IvoZal/DP/Fabrication output/testbench-BOM-THT-mouser.xlsx

Quantity | GME | Designator | Mouser number | URL
2 | KLS MLW10G konektor | J3 | 538-70246-1004 | https://cz.mouser.com/ProductDetail/Molex/70246-1004?qs=R7%2FZKp6KZ2by8%252BhtUWbo%252BQ%3D%3D
0 | pruzinovy pogo kontakt samice | U6 | 575-4141000150000000 | https://cz.mouser.com/ProductDetail/Mill-Max/4141-0-00-15-00-00-03-0?qs=Znm5pLBrcAKrk2sGDtRJwQ%3D%3D | https://www.digikey.com/en/products/detail/mill-max-manufacturing-corp/4141-0-00-15-00-00-03-0/16341759
0 | CONNFLY S2G06C, kolikova lista 2x3 pin | J2 | 649-1012938190602BLF | https://cz.mouser.com/ProductDetail/Amphenol-FCI/10129381-906002BLF?qs=DXv0QSHKF4zSKXKyBbBVMw%3D%3D
3 | dutinkova lista 8 pin | U7, U8 | 992-8FX1L-254MM | https://cz.mouser.com/ProductDetail/Gravitech/8Fx1L-254mm?qs=fkzBJ5HM%252BdAyuablm941Ag%3D%3D
0 | CONNFLY S1G02C kolíková lišta 1x2 pin | LS1 | 200-TSW10207TS | https://cz.mouser.com/ProductDetail/Samtec/TSW-102-07-T-S?qs=hzq9O0YpnZuE%252BS9CaLPVlQ%3D%3D
1 | BL104G-V5,7 dutinková lišta 1x4pin | U2 | 710-61300411821 | https://cz.mouser.com/ProductDetail/Wurth-Elektronik/61300411821?qs=iLbezkQI%252BsgYrk24CGHgKQ%3D%3D
3 | dutinková lišta 1x6pin 2.54mm roztec | U4, U8 | 710-61300611821 | https://cz.mouser.com/ProductDetail/Wurth-Elektronik/61300611821?qs=iLbezkQI%252BsgS21jF2eozhA%3D%3D
1 | KLS BL105G-V8.5 dutinková lišta 1x5 pin | U3 | 710-61300511821 | https://cz.mouser.com/ProductDetail/Wurth-Elektronik/61300511821?qs=iLbezkQI%252BsjtLywwvTh3KA%3D%3D
0 | CONNFLY S1G04C kolíková lišta 1x4 pin | U6 | 523-G800W304018EU | https://cz.mouser.com/ProductDetail/Amphenol-Commercial-Products/G800W304018EU?qs=f9yNj16SXrKi9QS16pMdvA%3D%3D
0 | CONNFLY S1G06C kolíková lišta 1x6 | U5 | 649-1012937890601BLF | https://cz.mouser.com/ProductDetail/Amphenol-FCI/10129378-906001BLF?qs=0lQeLiL1qybdgsDy2F9d0g%3D%3D
0 | KLS S1G08C kolíková lišta 1x8 | U5 | 649-1012937890801BLF | https://cz.mouser.com/ProductDetail/Amphenol-FCI/10129378-908001BLF?qs=0lQeLiL1qybDtVkZc9V5DA%3D%3D
0 | KLS S1G10C kolíková lišta 1x10 | U5 | 649-1012937891001BLF | https://cz.mouser.com/ProductDetail/Amphenol-FCI/10129378-910001BLF?qs=0lQeLiL1qyaKTim8PTf2WA%3D%3D
0 | distancni slopek plastovy 10mm
1 | 5 zilovy kabel
 | 1x kabel 5 zilovy samec/samice
 | 1x kabel 4 zilovy samice/samice
pogo piny
tme | https://www.tme.eu/cz/details/pogo-pin2mmx11.3mm/konektory-ostatni/
