IvoZal/DP/Fabrication output/testbench-BOM.xlsx

Comment | Designator | Footprint | LCSC Part Number
100n | C4,C7,C9,C11,C8,C6,C5 | 0805 | C28233
1uF | C10 | 0805 | C28323
1k | R23,R17,R21,R28,R20,R27,R22,R24,R18,R25,R19,R26 | 0805 | C17513
22p | C3,C2 | 0805 | C1804
5.1k | R2,R1 | 0805 | C27834
10k | R10,R12,R11,R13,R9 | 0805 | C17414
330R | R33,R38,R7,R45,R35,R42,R36,R47,R41,R56,R53,R43,R54,R5,R16,R44,R6,R48,R29,R34,R3,R46,R32,R37,R31,R49,R52,R39,R55,R40,R51,R50,R30 | 0805 | C17630
LED green | D1 | 0805 | C2297
USB-TYPE-C | J1 |  | C5307759
USBLC6-2SC6 | U9 | SOT-23-6 | C85364
ATmega2561-16A | U1 | TQFP-64 | C113558
200R | R14 | 0805 | C17540
4.7uF | C1 | 0805 | C1779
CH340C | U10 | SOIC-16 | C84681
100R@100MHz | FB1 | 0805 | C1015
4.7k | R4 | 0805 | C17673
16MHz | Y1 | SMD3225-4P | C13738
470R | R15 | 0805 | C17710
NO Tactile SPST | SW1 | SMD | C318884
500mA | F1 | 0805 | C2833485
1M | R8 | 0805 | C17514
