IvoZal/DP/test-report.csv

Kit number | ATmega328P Xplained Mini | Rele modul | RTC a EEPROM modul | Rotacni enkoder | Maticova klavesnice | Tlacitka na LCD modulu | Modul LCD displeje | Reproduktor | Modul s termistorem
009 | FAIL | PASS | PASS | PASS | PASS | PASS | PASS | PASS | PASS
017 | FAIL | PASS | PASS | PASS | PASS | PASS | PASS | PASS | PASS
013 | PASS | PASS | PASS | PASS | PASS | PASS | PASS | PASS | PASS
