IvoZal/DP/testbench-PCB/testbench.kicad_pcb

## KiCad design testbench-PCB/testbench.kicad_pcb (2023-12-13)

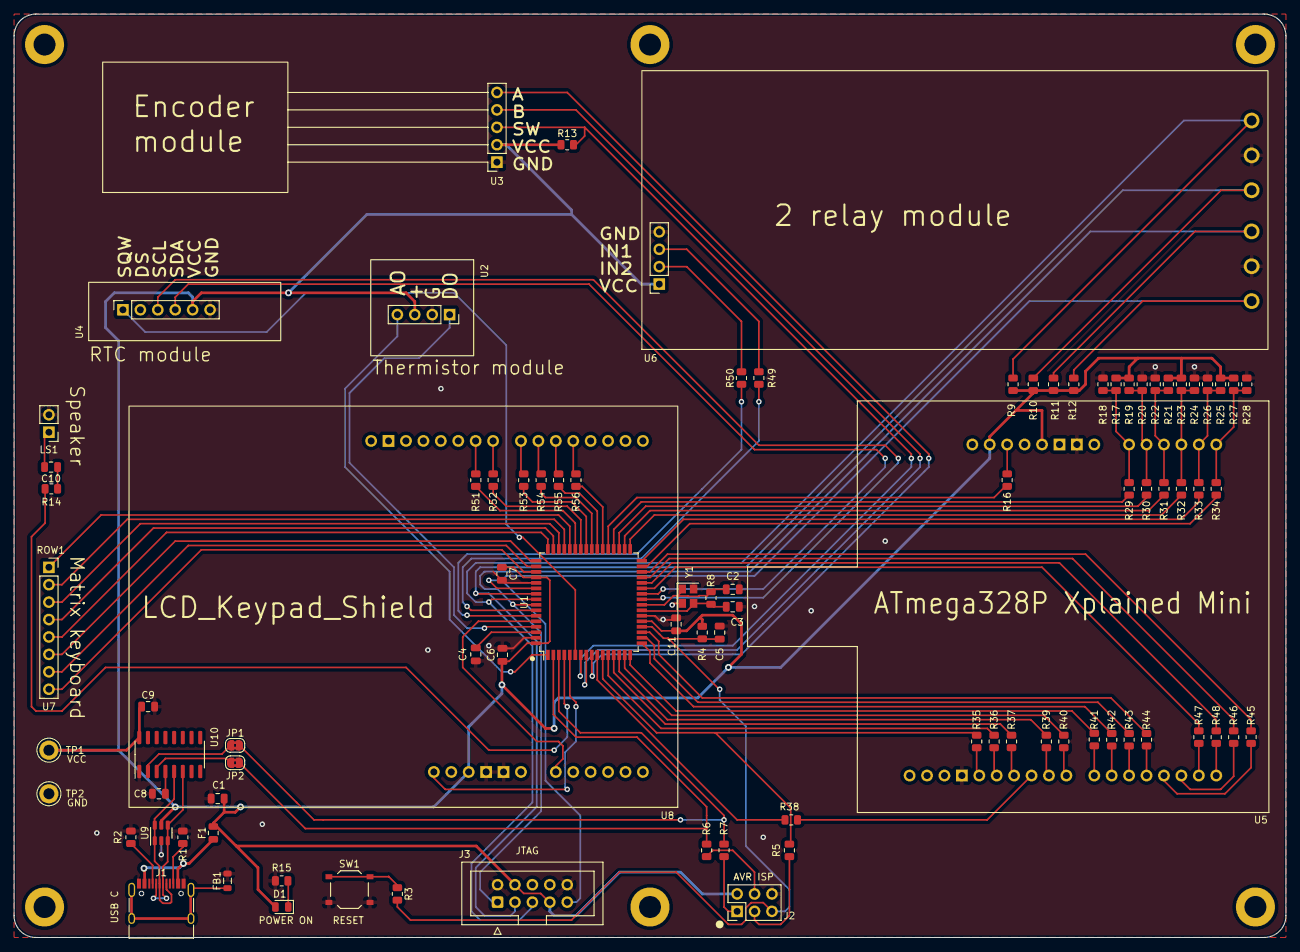
[picture p1: board testbench.kicad_pcb from above]

Board: 2 copper layers, 185.4 x 134.6 mm, 90 parts (0 on the bottom side), 105 nets.

Parts:
C1: 4.7uF; C_0805_2012Metric
C2, C3: 22p; C_0805_2012Metric
C4, C5, C6, C7, C8, C9, C11: 100n; C_0805_2012Metric
C10: 1uF; C_0805_2012Metric
D1: LED; LED_0805_2012Metric
F1: 500mA; Fuse_0805_2012Metric
FB1: 100R@100MHz; L_0805_2012Metric
J1: USB_C_Receptacle_USB2.0; USB_C_Receptacle_HRO_TYPE-C-31-M-12
J2: AVR-ISP; PinHeader_2x03_P2.54mm_Vertical
J3: AVR-JTAG; IDC-Header_2x05_P2.54mm_Vertical
JP1, JP2: SolderJumper_2_Bridged; SolderJumper-2_P1.3mm_Bridged2Bar_RoundedPad1.0x1.5mm
LS1: Speaker; PinHeader_1x02_P2.54mm_Vertical
R1, R2: 5.1k; R_0805_2012Metric
R3, R5, R6, R7, R16, R29, R30, R31, R32, R33, R34, R35, R36, R37, R38, R39, R40, R41, R42, R43, R44, R45, R46, R47, R48, R49, R50, R51, R52, R53, R54, R55, R56: 330R; R_0805_2012Metric
R4: 4.7k; R_0805_2012Metric
R8: 1M; R_0805_2012Metric
R9, R10, R11, R12, R13: 10k; R_0805_2012Metric
R14: 200R; R_0805_2012Metric
R15: 470R; R_0805_2012Metric
R17, R18, R19, R20, R21, R22, R23, R24, R25, R26, R27, R28: 1k; R_0805_2012Metric
SW1: SW_Push; SW_Push_1P1T_XKB_TS-1187A
TP1, TP2: TestPoint; TestPoint_Keystone_5005-5009_Compact
U1: ATmega2561-16A; TQFP-64_14x14mm_P0.8mm
U2: Thermistor_module
U3: Rotary_encoder_switch_module; Rotary_encoder_module
U4: RTC_EEPROM_module; RTC_module
U5: ATmega328P_Xplained_mini
U6: Relay_module
U7: Matrix_keyboard; PinSocket_1x08_P2.54mm_Vertical
U8: LCD_display; LCD_1602A_module
U9: USBLC6-2SC6; SOT-23-6
U10: CH340C; SOIC-16_3.9x9.9mm_P1.27mm
Y1: X322516MLB4SI; Oscillator_SMD_Abracon_ASE-4Pin_3.2x2.5mm

Connections:
+5V: C1.1, C6.1, C7.1, C9.1, C11.1, D1.2 (A), F1.2, J2.2 (VCC), J3.4 (VREF), J3.7 (VCC), R4.1, R9.1, R10.1, R11.1, R12.1, R13.1, R17.1, R19.1, R21.1, R23.1, R25.1, R27.1, TP1.1, U1.21 (VCC), U1.52 (VCC), U1.64 (AVCC), U2.3 (+), U3.4 (+), U4.5 (VCC), U5.20 (VCC), U5.23 (5V), U6.4 (Vcc), U8.19 (5V), U9.5 (VBUS), U10.16 (VCC)
/ATmega328P module/D0: R16.2, U5.21 (~RESET/PC6)
/ATmega328P module/D1: R17.2, R18.1, R29.2, U5.27 (PC0)
/ATmega328P module/D2: R19.2, R20.1, R30.2, U5.28 (PC1)
/ATmega328P module/D3: R21.2, R22.1, R31.2, U5.29 (PC2)
/ATmega328P module/D4: R23.2, R24.1, R32.2, U5.30 (PC3)
/ATmega328P module/D5: R25.2, R26.1, R33.2, U5.31 (PC4)
/ATmega328P module/D6: R27.2, R28.1, R34.2, U5.32 (PC5)
/ATmega328P module/D7: R35.1, U5.14 (PB5)
/ATmega328P module/D8: R36.1, U5.13 (PB4)
/ATmega328P module/D9: R37.1, U5.12 (PB3)
/ATmega328P module/D10: R38.1, U5.11 (PB2)
/ATmega328P module/D11: R39.1, U5.10 (PB1)
/ATmega328P module/D12: R40.1, U5.9 (PB0)
/ATmega328P module/D13: R41.1, U5.8 (PD7)
/ATmega328P module/D14: R42.1, U5.7 (PD6)
/ATmega328P module/D15: R43.1, U5.6 (PD5)
/ATmega328P module/D16: R44.1, U5.5 (PD4)
/ATmega328P module/D17: R45.1, U5.4 (PD3)
/ATmega328P module/D18: R46.1, U5.3 (PD2)
/ATmega328P module/D19: R47.1, U5.2 (PD1)
/ATmega328P module/D20: R48.1, U5.1 (PD0)
/ATmega328P module/DUT_D0: R16.1, U1.37 (PC2)
/ATmega328P module/DUT_D1: R29.1, U1.36 (PC1)
/ATmega328P module/DUT_D2: R30.1, U1.35 (PC0)
/ATmega328P module/DUT_D3: R31.1, U1.34 (PG1)
/ATmega328P module/DUT_D4: R32.1, U1.33 (PG0)
/ATmega328P module/DUT_D5: R33.1, U1.32 (PD7)
/ATmega328P module/DUT_D6: R34.1, U1.31 (PD6)
/ATmega328P module/DUT_D7: R48.2, U1.28 (PD3)
/ATmega328P module/DUT_D8: R47.2, U1.27 (PD2)
/ATmega328P module/DUT_D9: R46.2, U1.29 (PD4)
/ATmega328P module/DUT_D10: R45.2, U1.30 (PD5)
/ATmega328P module/DUT_D11: R44.2, U1.19 (PG4)
/ATmega328P module/DUT_D12: R43.2, U1.18 (PG3)
/ATmega328P module/DUT_D13: R42.2, U1.17 (PB7)
/ATmega328P module/DUT_D14: R41.2, U1.16 (PB6)
/ATmega328P module/DUT_D15: R40.2, U1.15 (PB5)
/ATmega328P module/DUT_D16: R39.2, U1.14 (PB4)
/ATmega328P module/DUT_D17: R38.2, U1.10 (PB0)
/ATmega328P module/DUT_D18: R37.2, U1.13 (PB3)
/ATmega328P module/DUT_D19: R36.2, U1.12 (PB2)
/ATmega328P module/DUT_D20: R5.1, R35.2, U1.11 (PB1)
/Kit modules/ENC.A: U1.9 (PE7), U3.1 (CLK)
/Kit modules/ENC.B: U1.8 (PE6), U3.2 (DT)
/Kit modules/ENC.SW: R13.2, U1.7 (PE5), U3.3 (SW)
/Kit modules/I2C_SCL: U1.25 (PD0), U4.3 (SCL)
/Kit modules/I2C_SDA: U1.26 (PD1), U4.4 (SDA)
/Kit modules/K1-IN: R49.1, U1.58 (PF3)
/Kit modules/K1-NC: J3.5 (TMS), R9.2, U1.56 (PF5), U6.5 (K1-NC)
/Kit modules/K1-NO: J3.3 (TDO), R10.2, U1.55 (PF6), U6.7 (K1-NO)
/Kit modules/K2-IN: R50.1, U1.59 (PF2)
/Kit modules/K2-NC: J3.1 (TCK), R11.2, U1.57 (PF4), U6.8 (K2-NC)
/Kit modules/K2-NO: J3.9 (TDI), R12.2, U1.54 (PF7), U6.10 (K2-NO)
/Kit modules/KEY_D0: U1.44 (PA7), U7.1 (ROW1)
/Kit modules/KEY_D1: U1.45 (PA6), U7.2 (ROW2)
/Kit modules/KEY_D2: U1.46 (PA5), U7.3 (ROW3)
/Kit modules/KEY_D3: U1.47 (PA4), U7.4 (ROW4)
/Kit modules/KEY_D4: U1.48 (PA3), U7.5 (COL1)
/Kit modules/KEY_D5: U1.49 (PA2), U7.6 (COL2)
/Kit modules/KEY_D6: U1.50 (PA1), U7.7 (COL3)
/Kit modules/KEY_D7: U1.51 (PA0), U7.8 (COL4)
/Kit modules/LCD_AO: U1.60 (PF1), U8.23 (A0)
/Kit modules/LCD_D0: R56.2, U1.38 (PC3)
/Kit modules/LCD_D1: R55.2, U1.39 (PC4)
/Kit modules/LCD_D2: R54.2, U1.40 (PC5)
/Kit modules/LCD_D3: R53.2, U1.41 (PC6)
/Kit modules/LCD_D4: R52.2, U1.42 (PC7)
/Kit modules/LCD_D5: R51.2, U1.43 (PG2)
/Kit modules/LCD_D6: U1.5 (PE3), U8.17 (RST)
/Kit modules/RTC_SQW: U1.6 (PE4), U4.1 (SQ)
/Kit modules/Speaker_IN: R14.1, U1.4 (PE2)
/Kit modules/Thermistor_AO: U1.61 (PF0), U2.1 (AO)
/Kit modules/Thermistor_DO: U1.1 (PG5), U2.4 (DO)
/MCU/RST: C5.1, J2.5 (~RST), R3.2, R4.2, U1.20 (~RESET)
/MCU/UART0_RXD: JP2.2 (B), R6.1, U1.2 (PE0)
/MCU/UART0_TXD: JP1.2 (B), R7.1, U1.3 (PE1)
/USB Interface/VBUS: F1.1, J1.A4 (VBUS), J1.A9 (VBUS), J1.B4 (VBUS), J1.B9 (VBUS)
GND: C1.2, C2.1, C3.1, C4.2, C5.2, C6.2, C7.2, C8.2, C9.2, C11.2, FB1.2, J1.A1 (GND), J1.A12 (GND), J1.B1 (GND), J1.B12 (GND), J2.6 (GND), J3.2 (GND), J3.10 (GND), LS1.2, R1.2, R2.2, R15.2, R18.2, R20.2, R22.2, R24.2, R26.2, R28.2, SW1.2, TP2.1, U1.22 (GND), U1.53 (GND), U1.63 (GND), U2.2 (GND), U3.5 (GND), U4.6 (GND), U5.15 (GND), U5.25 (GND), U6.1 (GND), U6.6 (K1-COM), U6.9 (K2-COM), U8.20 (GND), U8.21 (GND), U9.2 (GND), U10.1 (GND), Y1.2, Y1.4
unnamed: C10.1, R14.2
unnamed: C10.2, LS1.1
unnamed: D1.1 (K), R15.1
unnamed: J1.A5 (CC1), R2.1
unnamed: J1.B5 (CC2), R1.1
unnamed: FB1.1, J1.S1 (SHIELD)
unnamed: J2.1 (MISO), R7.2
unnamed: J2.4 (MOSI), R6.2
unnamed: J2.3 (SCK), R5.2
unnamed: JP1.1 (A), U10.2 (TXD)
unnamed: JP2.1 (A), U10.3 (RXD)
unnamed: R3.1, SW1.1
unnamed: C4.1, U1.62 (AREF)
unnamed: C2.2, R8.1, U1.24 (XTAL1), Y1.1
unnamed: C3.2, R8.2, U1.23 (XTAL2), Y1.3
unnamed: R49.2, U6.2 (IN1)
unnamed: R50.2, U6.3 (IN2)
unnamed: R56.1, U8.5 (D4)
unnamed: R55.1, U8.6 (D5)
unnamed: R54.1, U8.7 (D6)
unnamed: R53.1, U8.8 (D7)
unnamed: R51.1, U8.10 (E)
unnamed: R52.1, U8.9 (RS)
unnamed: J1.A6 (D+), J1.B6 (D+), U9.1 (I/O1), U9.6 (I/O1), U10.5 (UD+)
unnamed: J1.A7 (D-), J1.B7 (D-), U9.3 (I/O2), U9.4 (I/O2), U10.6 (UD-)
unnamed: C8.1, U10.4 (V3)
