IvoZal/DP/test_app/testappcontrol.py

import tkinter as tk
import threading
import time
import subprocess
import csv
import sys

class Device:
    def __init__(self, name):
        self.name = name
        self.run = True
        self.tk_var = tk.BooleanVar(value=self.run)
        self.result = "INIT"
        self.err_message = ""
        self.label = {"status" : None, "error" : None}
        self.data = []
        self.serial_read_flag = False

class TestAppController:
    def __init__(self, model, view):
        self.model = model
        self.view = view
        self.selected_port = tk.StringVar(value="")
        self.log_flag = tk.IntVar()
        self.log_filename = ""
        self.test_devices = [Device("ATmega328P Xplained Mini"),
                             Device("Rele modul"),
                             Device("RTC a EEPROM modul"),
                             Device("Rotacni enkoder"),
                             Device("Maticova klavesnice"),
                             Device("Tlacitka na LCD modulu"),
                             Device("Modul LCD displeje"),
                             Device("Reproduktor"),
                             Device("Modul s termistorem"),]
        
    def start_adc_read(self, device):
        while device.serial_read_flag:
            try:
                data = self.model.read_data(None)
                raw_data = int(data.replace("ADC: ",""))
                device.data.append(5*raw_data/1023)
                if len(device.data) > 20:
                    device.data.pop(0)
            except ValueError:
                pass
            
    def interact_test(self, device):
        def check_serial_data():
            nonlocal device
            while device.serial_read_flag:
                try:
                    test_result = self.model.eval_test(0)
                    if test_result[0]:
                        device.result = "PASS"
                        device.err_message = ""
                        self.view.window.save_result(True)
                    elif test_result[1] != "":
                        device.result = "FAIL"
                        device.err_message = test_result[1]
                        self.view.window.missing_input(device.err_message)
                except Exception as e:
                    print(f"Error in check_serial_data: {e}")
                time.sleep(0.1)

        # Start the serial reading loop in a separate thread
        serial_reader_thread = threading.Thread(target=check_serial_data)
        serial_reader_thread.start()

    def program_m328p(self):
        self.view.update_prog_status("Nahrávání...")
        time.sleep(0.1)
        if getattr(sys, 'frozen', False):
            # Running in PyInstaller
            avrdude_path = sys._MEIPASS + "/avrdude"
            binary_path = sys._MEIPASS + "/ATmega328P_test_prog.hex"
        else:
            # Running in a Python environment
            avrdude_path = "avrdude/avrdude"
            binary_path = "m328p_binary/ATmega328P_test_prog.hex"
        
        avrdude_cmd = avrdude_path + " -p m328p -c xplainedmini_dw -U flash:w:" + binary_path
        print(avrdude_cmd)
        try:
            subprocess.check_output(avrdude_cmd)
            self.view.update_prog_status("Program byl úspěšně nahrán.")
        except subprocess.CalledProcessError as e:
            self.view.update_prog_status("Nahrávání programu selhalo.")
        
    def start_clicked(self):
        com_port = self.selected_port.get()
        self.view.err_label.config(text="")
        try:
            self.model.init_serial(com_port, 38400)
            self.view.comm_label.config(text="Vybrán port " + com_port)
        except Exception as e:
            if(com_port == ""):
                self.view.comm_label.config(text="COM port nebyl vybrán!")
            else:
                self.view.comm_label.config(text="Vybraný COM port není přístupný: " + com_port)
            pass
        else:
            self.model.write("TEST INIT")
            for device in self.test_devices:
                match device.name:
                    case "ATmega328P Xplained Mini":
                        device.err_message = ""
                        if(device.run):
                            test_result = self.model.self_test("TEST ATMEGA")
                            if(test_result[0]):
                                device.result = "PASS"
                            else:
                                device.result = "FAIL"
                                device.err_message = test_result[1]
                        else:
                            device.result = "SKIPPED"

                    case "Rele modul":
                        device.err_message = ""
                        if(device.run):
                            test_result = self.model.self_test("TEST RELAY")
                            if(test_result[0]):
                                device.result = "PASS"
                            else:
                                device.result = "FAIL"
                                device.err_message = test_result[1]
                        else:
                            device.result = "SKIPPED"

                    case "RTC a EEPROM modul":
                        device.err_message = ""
                        if(device.run):
                            test_result = self.model.self_test("TEST RTC", timeout=1)
                            if(test_result[0]):
                                device.result = "PASS"
                            else:
                                device.result = "FAIL"
                                device.err_message = test_result[1]
                        else:
                            device.result = "SKIPPED"

                    case "Rotacni enkoder":
                        device.err_message = ""
                        if(device.run):
                            self.model.write("TEST ENCODER")

                            test_thread = threading.Thread(target=self.interact_test, args=(device,))
                            device.serial_read_flag = True
                            test_thread.start()

                            self.view.open_window(device)   
                            device.serial_read_flag = False
                            self.model.write("STOP")      
                        else:
                            device.result = "SKIPPED"

                    case "Maticova klavesnice":
                        device.err_message = ""
                        if(device.run):
                            device.result = "INIT"
                            self.model.write("TEST KEYBRD")

                            test_th = threading.Thread(target=self.interact_test, args=(device,))
                            device.serial_read_flag = True
                            test_th.start()

                            self.view.open_window(device)        
                            device.serial_read_flag = False  
                            self.model.write("STOP")
                        else:
                            device.result = "SKIPPED"

                    case "Tlacitka na LCD modulu":
                        device.err_message = ""
                        if(device.run):
                            device.result = "INIT"
                            self.model.write("TEST BTN")

                            test_th = threading.Thread(target=self.interact_test, args=(device,))
                            device.serial_read_flag = True
                            test_th.start()

                            self.view.open_window(device)        
                            device.serial_read_flag = False  
                            self.model.write("STOP")
                        else:
                            device.result = "SKIPPED"

                    case "Modul LCD displeje":
                        device.err_message = ""
                        if(device.run):
                            self.model.write("TEST LCD")
                            self.view.open_window(device)
                            self.model.write("STOP")
                        else:
                            device.result = "SKIPPED"

                    case "Reproduktor":
                        if(device.run):
                            self.model.write("TEST SPEAKER")
                            self.view.open_window(device)
                            self.model.write("STOP")
                        else:
                            device.result = "SKIPPED"

                    case "Modul s termistorem":
                        if(device.run):
                            self.model.write("TEST THERM")

                            device.serial_read_flag = True
                            serial_thread = threading.Thread(target=self.start_adc_read, args=(device,))
                            serial_thread.start()

                            self.view.open_window(device)   
                            device.serial_read_flag = False
                            self.model.write("STOP")                 
                        else:
                            device.result = "SKIPPED"

                    case others:
                        pass
                    
                self.view.update_status_label(device)
                self.model.ser.reset_input_buffer()
                time.sleep(0.01)
            self.model.close_serial()
            self.view.update_prog_status("")

            if(self.log_flag.get() == 1):
                if(self.log_filename != ""):
                    kit_name = self.view.get_kit_name()
                    if kit_name is not None:
                        try:
                            csvfile = open(self.log_filename, 'a', newline='')
                            writer = csv.writer(csvfile)
                            report_list = [kit_name]
                            for device in self.test_devices:
                                report_list.append(device.result)
                            writer.writerow(report_list)
                            csvfile.close()
                        except Exception as e:
                            self.view.err_label.config(text="Chyba při zápisu do souboru!")
                    else:
                        self.view.err_label.config(text="Nebylo zadáno číslo kitu, report nebyl uložen!")
                else:
                    self.view.err_label.config(text="Logovací soubor nebyl vytvořen!")
