IvoZal/DP/ATmega2561_test_program/atmega2561_example/src/driver_init.c

/**
 * \file
 *
 * \brief Driver initialization.
 *
 (c) 2020 Microchip Technology Inc. and its subsidiaries.

    Subject to your compliance with these terms,you may use this software and
    any derivatives exclusively with Microchip products.It is your responsibility
    to comply with third party license terms applicable to your use of third party
    software (including open source software) that may accompany Microchip software.

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
    IN NO EVENT WILL MICROCHIP BE LIABLE FOR ANY INDIRECT, SPECIAL, PUNITIVE,
    INCIDENTAL OR CONSEQUENTIAL LOSS, DAMAGE, COST OR EXPENSE OF ANY KIND
    WHATSOEVER RELATED TO THE SOFTWARE, HOWEVER CAUSED, EVEN IF MICROCHIP HAS
    BEEN ADVISED OF THE POSSIBILITY OR THE DAMAGES ARE FORESEEABLE. TO THE
    FULLEST EXTENT ALLOWED BY LAW, MICROCHIP'S TOTAL LIABILITY ON ALL CLAIMS IN
    ANY WAY RELATED TO THIS SOFTWARE WILL NOT EXCEED THE AMOUNT OF FEES, IF ANY,
    THAT YOU HAVE PAID DIRECTLY TO MICROCHIP FOR THIS SOFTWARE.
 *
 */

/*
 * Code generated by START.
 *
 * This file will be overwritten when reconfiguring your START project.
 * Please copy examples or other code you want to keep to a separate file
 * to avoid losing it when reconfiguring.
 */

#include "driver_init.h"
#include <system.h>

/* Configure pins and initialize registers */
void ADC_0_initialization(void)
{

	ADC_0_init();
}

/* configure the pins and initialize the registers */
void SPI_0_initialization(void)
{

	// Set pin direction to input
	PB3_set_dir(PORT_DIR_IN);

	PB3_set_pull_mode(
	    // <y> Pull configuration
	    // <id> pad_pull_config
	    // <PORT_PULL_OFF"> Off
	    // <PORT_PULL_UP"> Pull-up
	    PORT_PULL_OFF);

	// Set pin direction to output
	PB2_set_dir(PORT_DIR_OUT);

	PB2_set_level(
	    // <y> Initial level
	    // <id> pad_initial_level
	    // <false"> Low
	    // <true"> High
	    false);

	// Set pin direction to output
	PB1_set_dir(PORT_DIR_OUT);

	PB1_set_level(
	    // <y> Initial level
	    // <id> pad_initial_level
	    // <false"> Low
	    // <true"> High
	    false);

	SPI_init();
	SPI_disable();
}

/* configure pins and initialize registers */
void USART_0_initialization(void)
{

	// Set pin direction to input
	PE0_set_dir(PORT_DIR_IN);

	PE0_set_pull_mode(
	    // <y> Pull configuration
	    // <id> pad_pull_config
	    // <PORT_PULL_OFF"> Off
	    // <PORT_PULL_UP"> Pull-up
	    PORT_PULL_OFF);

	// Set pin direction to output
	PE1_set_dir(PORT_DIR_OUT);

	PE1_set_level(
	    // <y> Initial level
	    // <id> pad_initial_level
	    // <false"> Low
	    // <true"> High
	    false);

	USART0_init(38400);
}

/* configure pins and initialize registers */
void USART_1_initialization(void)
{

	// Set pin direction to input
	PD2_set_dir(PORT_DIR_IN);

	PD2_set_pull_mode(
	    // <y> Pull configuration
	    // <id> pad_pull_config
	    // <PORT_PULL_OFF"> Off
	    // <PORT_PULL_UP"> Pull-up
	    PORT_PULL_OFF);

	// Set pin direction to output
	PD3_set_dir(PORT_DIR_OUT);

	PD3_set_level(
	    // <y> Initial level
	    // <id> pad_initial_level
	    // <false"> Low
	    // <true"> High
	    false);

	USART1_init(38400);
}

/**
 * \brief System initialization
 */
void system_init()
{
	mcu_init();

	sysctrl_init();

	ADC_0_initialization();

	SPI_0_initialization();

	USART_0_initialization();

	USART_1_initialization();
}
