IvoZal/DP/(commit log)

2023-10-29 Added project, schematics.
    [testbench-backups.kicad_pcb, testbench-backups.kicad_sch]
2023-10-30 Added the rest of kit modules.
    [testbench-backups.kicad_sch]
2023-10-30 Added minimal MCU circuit, power supply from USB.
    [kit_modules.kicad_sch, power_supply.kicad_sch, testbench-backups.kicad_sch, untitled.kicad_sch]
2023-10-30 Changed USB interface name, MCU moved to separate sheet.
    [kit_modules.kicad_sch, mcu.kicad_sch, testbench-backups.kicad_sch, usb_interface.kicad_sch]
2023-10-30 Renamed whole project.
    [testbench.kicad_pcb, testbench.kicad_sch]
2023-11-05 Added USB interface.
    [kit_modules.kicad_sch, mcu.kicad_sch, testbench.kicad_sch, usb_interface.kicad_sch]
2023-11-06 Added connection between some modules.
    [kit_modules.kicad_sch, mcu.kicad_sch, testbench.kicad_sch, untitled.kicad_sch, usb_interface.kicad_sch]
2023-11-07 Finished connection between modules and MCU.
    [kit_modules.kicad_sch, mcu.kicad_sch, testbench.kicad_sch, untitled.kicad_sch, usb_interface.kicad_sch]
2023-11-08 Added footprints to few parts.
    [kit_modules.kicad_sch, mcu.kicad_sch]
2023-11-09 Changed naming convention.
    [kit_modules.kicad_sch, mcu.kicad_sch, testbench.kicad_sch, untitled.kicad_sch, usb_interface.kicad_sch]
2023-11-11 Connecter speaker, added JTAG.
    [kit_modules.kicad_sch, mcu.kicad_sch, testbench.kicad_sch, usb_interface.kicad_sch]
2023-11-11 Created PCB, changed footprints for symbols.
    [kit_modules.kicad_sch, mcu.kicad_sch, testbench.kicad_pcb, usb_interface.kicad_sch]
2023-11-12 Updated footprints, PCB.
    [kit_modules.kicad_sch, testbench.kicad_pcb, usb_interface.kicad_sch]
2023-11-12 Added submodule with KiCad lib.
2023-11-12 Routed osc., USB interface.
    [kit_modules.kicad_sch, mcu.kicad_sch, testbench.kicad_pcb, usb_interface.kicad_sch]
2023-11-14 Rearanged PCB, updated footprints.
    [mcu.kicad_sch, testbench.kicad_pcb, testbench.kicad_sch, untitled.kicad_sch]
2023-11-14 Renamed atmega328p sheet.
    [atmega328p.kicad_sch, testbench.kicad_sch]
2023-11-14 Fixed footprints in schematics.
    [atmega328p.kicad_sch, kit_modules.kicad_sch, testbench.kicad_pcb]
2023-11-20 Routing the PCB.
    [atmega328p.kicad_sch, kit_modules.kicad_sch, mcu.kicad_sch, testbench.kicad_pcb, testbench.kicad_sch, usb_interface.kicad_sch]
2023-11-21 Finished PCB routing, added ground plane.
    [kit_modules.kicad_sch, mcu.kicad_sch, testbench.kicad_pcb, usb_interface.kicad_sch]
2023-11-21 Resolved DRC warnings and errors.
    [testbench.kicad_pcb]
2023-11-21 Changes regarding part selection.
    [testbench-BOM.xlsx, testbench.kicad_pcb, usb_interface.kicad_sch]
2023-11-21 Changed encoder module pinout, added labels.
    [mcu.kicad_sch, testbench-BOM.csv, testbench.kicad_pcb]
2023-11-27 Added protective resistors.
    [atmega328p.kicad_sch, kit_modules.kicad_sch, testbench.kicad_pcb]
2023-11-27 Added logo and label. Rearanged labels.
    [testbench.kicad_pcb]
2023-11-27 DRC resolved.
    [testbench-BOM.csv, testbench-BOM.xlsx, testbench.kicad_pcb]
2023-11-28 Labels moved in schematics.
    [atmega328p.kicad_sch, kit_modules.kicad_sch, mcu.kicad_sch]
2023-12-05 Edited relay module output pins.
    [testbench.kicad_pcb]
2023-12-05 Exported fabrication outputs.
    [testbench-BOM.xlsx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]
2023-12-05 BOM for THT parts.
    [testbench-BOM-THT.xlsx]
2023-12-05 Created projects for both MCUs. Added gitignores.
    [testbench-BOM-THT-mouser.xlsx]
2024-01-04 Fixed adc reading.
2024-01-04 Added missing function definition.
    [uart.h]
2024-01-05 Error returned if invalid cmd passed.
    [main.c]
2024-01-05 Added uart lib.
2024-01-14 Added start and exit button.
2024-01-30 Fixed COM port menu, added label for communication.
    [testappview.py]
2024-01-31 Added draft for display and thermistor test view.
2024-02-01 Added thermistor test graph, TBD: graph update from serial.
2024-02-03 Added encoder test case.
2024-02-03 Edited error label printing.
    [testappview.py]
2024-02-03 Added matrix keyboard test case.
2024-02-03 Run all tests in default, concendate error messages.
    [testappcontrol.py]
2024-02-05 Fixed thread while loop condition.
    [testappcontrol.py, testappview.py]
2024-02-05 Added frames around group of features, added error message print.
    [testappcontrol.py, testappview.py]
2024-02-06 Added GME part names for THT BOM.
    [testbench-BOM-THT-mouser.xlsx]
2024-02-06 Added library for higher level UART handling.
2024-02-08 Added function prototypes with functionality description.
2024-02-08 Added reproductor test case.
2024-02-08 Added function for common init, added thermistor test case.
2024-02-08 Added missing test for display buttons.
    [testappcontrol.py, testappview.py]
2024-02-08 Added test case for display button.
2024-02-12 Added missing header include and missing test case.
    [main.c, module_test.c]
2024-02-17 Changed I2C lib name.
2024-02-17 Added working encoder library.
2024-02-18 Restored the timer.h library for delay.
2024-02-18 Added full encoder test
2024-02-18 Fixed encoder test
2024-02-18 Improved stability of serial, edited error message print.
    [testappcontrol.py, testappview.py]
2024-02-19 Added relay test.
2024-02-22 Error message cleared at start of the test.
    [testappcontrol.py]
2024-02-22 Changed the keyboard library for current schematic.
2024-02-22 Added matrix keyboard test, edited encoder test - fail print timing.
    [main.c, module_test.c, module_test.h]
2024-02-22 Added LCD buttons test.
2024-02-26 Fixed relay test, added RTC SQW output test.
    [module_test.c]
2024-02-29 LCD library edited for current schematic.
2024-02-29 Fixed LCD button test.
    [module_test.c]
2024-03-01 LCD library fixed for current schematic.
    [lcd.c, lcd.h]
2024-03-01 Deleted unused i2c library.
2024-03-01 Fixed IIC library - enable in PRR0.
    [IIC.c]
2024-03-01 Fixed strange behavior of RTC test after POR.
    [module_test.c]
2024-03-02 Fixed LCD stream warning.
    [lcd.c, lcd.h]
2024-03-03 Use custom UART libarary.
2024-03-03 Removed setting reset pin of m328p, fixed pin names.
    [atmega_test.c]
2024-03-03 Increased delay between messages. SPI init disabled.
2024-03-04 Use custom SPI library.
2024-03-12 Fixed interact_test function, model write fix in progress.
    [testappcontrol.py, testappmodel.py]
2024-03-13 Added function for SPI block transfer, DUT fuse check.
2024-03-13 Edited BOM of THT parts.
    [testbench-BOM-THT-mouser.xlsx]
2024-03-15 Fixed LCD test - delay deleted.
    [main.c, module_test.c, module_test.h]
2024-03-16 Added m328p ADC test.
2024-03-17 Added PASS print if all tests passed.
2024-03-17 Added ADC reference test.
2024-03-17 Fixed LCD and thermistor test.
    [module_test.c]
2024-03-17 Added I2C fail detection. Fixed infinite loop.
    [DS1307.c, DS1307.h, I2C.h, IIC.c, module_test.c]
2024-03-17 Added option to (di)select all tests.
2024-03-17 Removed acknowledge print
2024-03-18 Added delay for adc reference voltage to stabilize.
    [atmega_test.c]
2024-03-30 Fixed stuck communication after programming.
    [atmega_test.c]
2024-03-30 Added I2C read timeout into EEPROM_read function.
2024-04-09 Shorten the delay before fails are printed; minor fix.
    [module_test.c]
2024-04-29 Added example test report.
    [test-report.csv]
2024-04-29 Fixed typo in app gui.
    [testappview.py]
2024-04-29 Added titles to schematics.
    [atmega328p.kicad_sch, kit_modules.kicad_sch, mcu.kicad_sch, testbench.kicad_sch, usb_interface.kicad_sch]
